app4mc-rover/rover-sense-layer-rev2/README.md

# rover-sense-layer-rev2
RoverSenseLayer Rev2 Circuit Board Design Files in KiCad

Comprehensive documentation link: https://app4mc-rover.github.io/rover-docs
