app4mc-rover/rover-sense-layer-rev2/(commit log)

2017-10-29 RoverSenseLayer Rev2 design files, fabrication files, schematics pdf, and .gitignore added.
    [rover-board-B.Cu.gbl, rover-board-B.Mask.gbs, rover-board-B.SilkS.gbo, rover-board-Edge.Cuts.gm1, rover-board-F.Cu.gtl, rover-board-F.Mask.gts, rover-board-F.SilkS.gto, rover-board-NPTH.drl]
2017-11-02 New revision 2.2 added: typo in OLED connector cleared, logo re-designed
    [rover-board-B.Cu.gbl, rover-board-B.Mask.gbs, rover-board-B.SilkS.gbo, rover-board-Edge.Cuts.gm1, rover-board-F.Cu.gtl, rover-board-F.Mask.gts, rover-board-F.SilkS.gto, rover-board-NPTH.drl]
2017-11-02 Changes regarding APPSTACLE logo
    [rover-board-B.Cu.gbl, rover-board-B.Mask.gbs, rover-board-B.SilkS.gbo, rover-board-Edge.Cuts.gm1, rover-board-F.Cu.gtl, rover-board-F.Mask.gts, rover-board-F.SilkS.gto]
2017-11-07 Rev2.3 is created: Buzzer footprint corrected, drill holes are made NPTH,Mechanical
    [rover-board-B.Cu.gbl, rover-board-B.Mask.gbs, rover-board-B.SilkS.gbo, rover-board-Edge.Cuts.gm1, rover-board-F.Cu.gtl, rover-board-F.Mask.gts, rover-board-F.SilkS.gto, rover-board-NPTH.drl]
2017-11-17 Revision 2.4 added: Component layer fix for I2C connection, SMD resistors changes to DIP
    [rover-board-B.Cu.gbl, rover-board-B.Mask.gbs, rover-board-B.SilkS.gbo, rover-board-Edge.Cuts.gm1, rover-board-F.Cu.gtl, rover-board-F.Mask.gts, rover-board-F.SilkS.gto, rover-board-NPTH.drl]
2017-11-23 Revision 2.5 added with the new logos
    [rover-board-B.Cu.gbl, rover-board-B.Mask.gbs, rover-board-B.SilkS.gbo, rover-board-Edge.Cuts.gm1, rover-board-F.Cu.gtl, rover-board-F.Mask.gts, rover-board-F.SilkS.gto, rover-board-NPTH.drl]
2017-11-27 Revision2.5 edited: corrected the magnetometer overlay
    [rover-board-B.Cu.gbl, rover-board-B.Mask.gbs, rover-board-B.SilkS.gbo, rover-board-Edge.Cuts.gm1, rover-board-F.Cu.gtl, rover-board-F.Mask.gts, rover-board-F.SilkS.gto, rover-board.drl]
2017-11-28 Revision 2.6 added: Magnetometer overlay corrected, DHT22 sensor VCC switched to 5V.
    [rover-board-B.Cu.gbl, rover-board-B.Mask.gbs, rover-board-B.SilkS.gbo, rover-board-Edge.Cuts.gm1, rover-board-F.Cu.gtl, rover-board-F.Mask.gts, rover-board-F.SilkS.gto, rover-board-NPTH.drl]
2017-11-28 Design rule violation track near pad is cleared
    [rover-board.kicad_pcb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]
2017-11-29 Revision 2.7 added
    [rover-board-B.Cu.gbl, rover-board-B.Mask.gbs, rover-board-B.SilkS.gbo, rover-board-Edge.Cuts.gm1, rover-board-F.Cu.gtl, rover-board-F.Mask.gts, rover-board-F.SilkS.gto, rover-board-NPTH.drl]
2017-11-29 Revision 2.8 added with accelerometer socket moved
    [rover-board-B.Cu.gbl, rover-board-B.Mask.gbs, rover-board-B.SilkS.gbo, rover-board-Edge.Cuts.gm1, rover-board-F.Cu.gtl, rover-board-F.Mask.gts, rover-board-F.SilkS.gto, rover-board-NPTH.drl]
